Bjornis-Kaso/Smart-Energy-Meter/media/hardware/resistors_on_perfboard.jpg

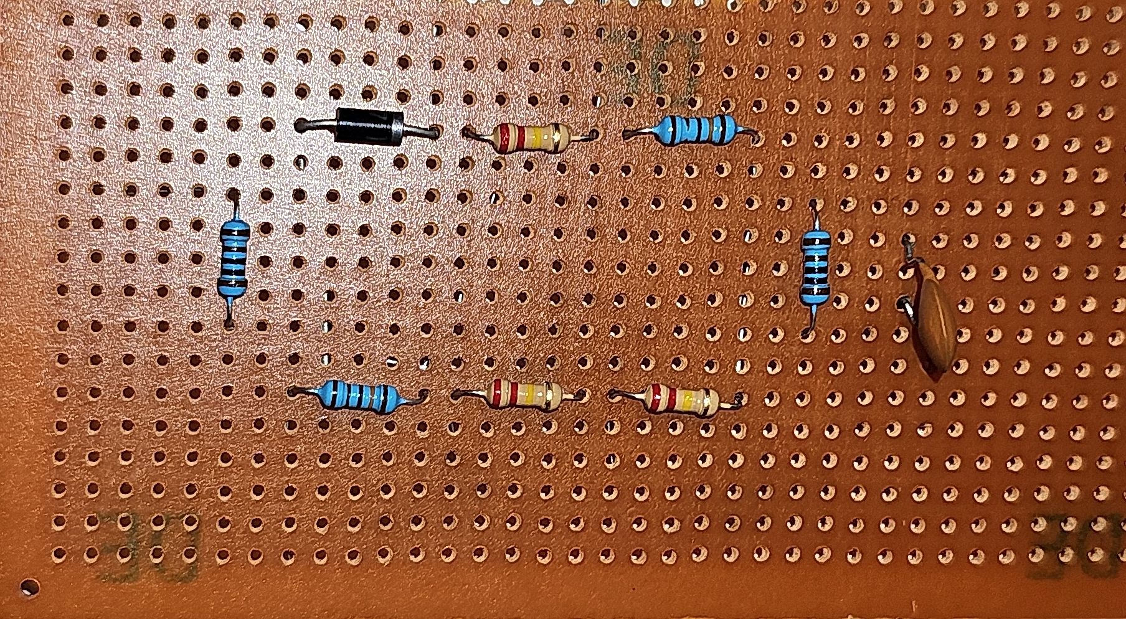
media/hardware/resistors_on_perfboard.jpg
