Bjornis-Kaso/Smart-Energy-Meter/media/schematics/V1_simulation_bjornis_klasa47.png

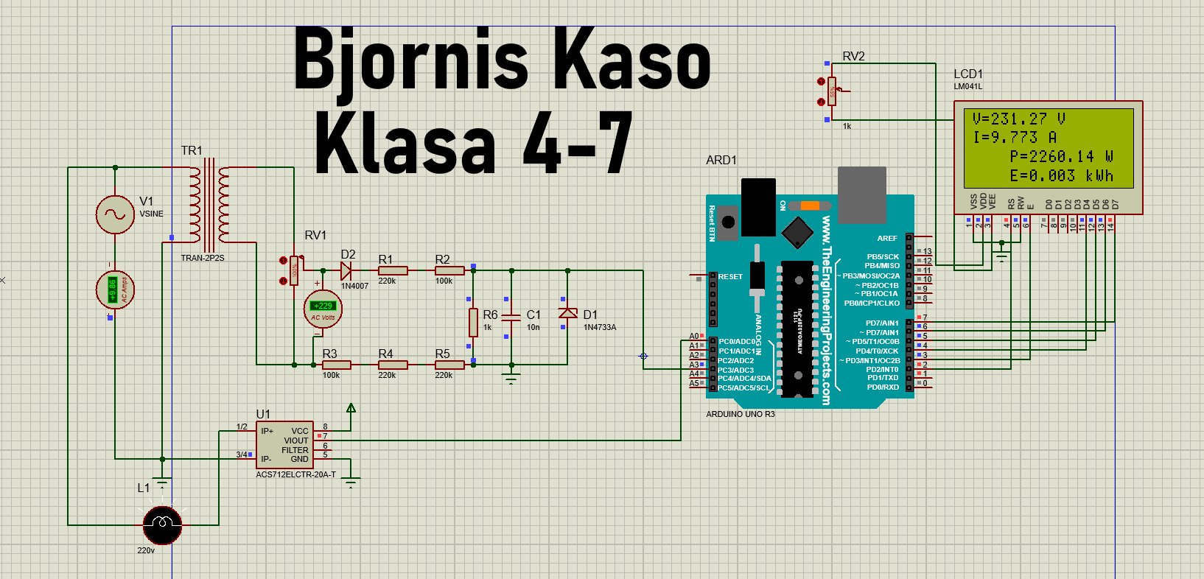
media/schematics/V1_simulation_bjornis_klasa47.png
