Bjornis-Kaso/Smart-Energy-Meter/media/schematics/V1_simulation_highload.png

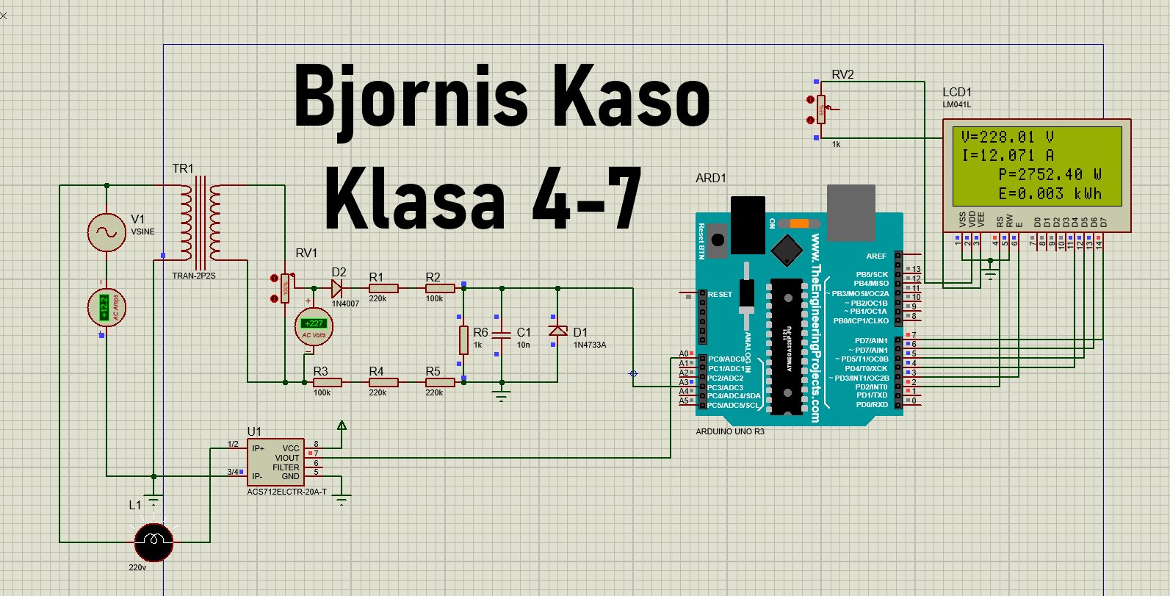
media/schematics/V1_simulation_highload.png
