Bjornis-Kaso/Smart-Energy-Meter/media/schematics/V2_simulation_running.png

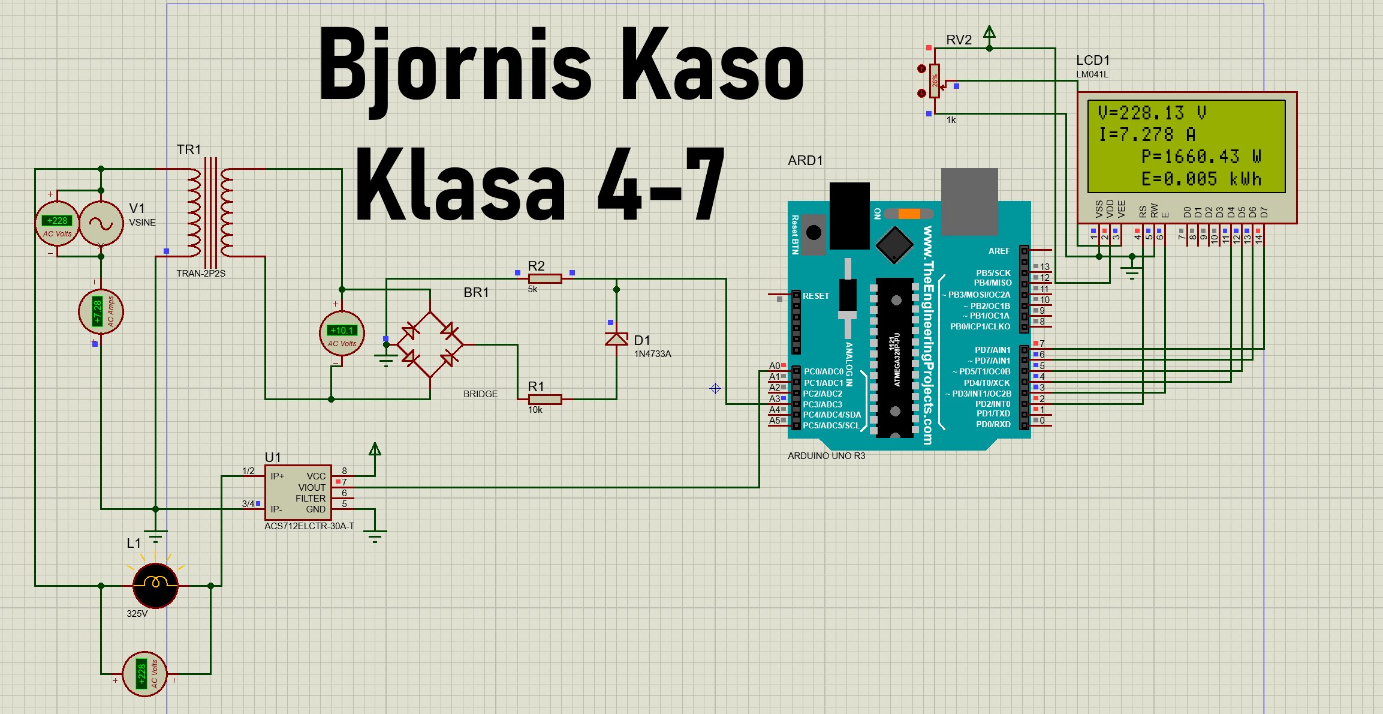
media/schematics/V2_simulation_running.png
