Bjornis-Kaso/Smart-Energy-Meter/calibration/calibration_sheet.md

# Calibration Sheet — Fletë Kalibrimi V4

**Method:** Comparison calibration  
**Date:** 21.03.2025
**Lead:** Bjornis Kaso  
**School:** Instituti Harry Fultz  

---

## Instrument Under Test (Mx) vs Reference Instrument (Mo)

**Quantity tested:** Power (W)  
**Measurement range:** Voltage 200–240 V, Current ~0.5 A  

---

## Voltage & Current Measurements

| # | Mx(V) | Mo(V) | Mx(A) | Mo(A) | Ga(V) | θ(V)  | Ga(A)  | θ(A) | Grl(V%) | Grl(A%) |
|---|---|---|---|---|---|---|---|---|---|---|
| 1 | 224.99 | 224.33 | 0.51 | 0.522 | 0.66 | -0.66 | -0.012 | 0.012 | 0.294% | 1.2%  |
| 2 | 225.70 | 225.60 | 0.51 | 0.514 | 0.10 | -0.10 | -0.004 | 0.004 | 0.044% | 0.8%  |
| 3 | 225.72 | 226.37 | 0.52 | 0.521 | -0.65| 0.65  | -0.001 | 0.001 | 0.287% | 0.2%  |
| 4 | 226.43 | 226.35 | 0.52 | 0.521 | 0.08 | -0.08 | -0.001 | 0.001 | 0.035% | 0.2%  |
| 5 | 226.84 | 227.05 | 0.51 | 0.527 | -0.21| 0.21  | -0.017 | 0.017 | 0.092% | 1.7%  |
| 6 | 227.35 | 227.05 | 0.52 | 0.527 | 0.30 | -0.30 | -0.007 | 0.007 | 0.132% | 0.7%  |
| 7 | 230.53 | 230.47 | 0.53 | 0.520 | 0.06 | -0.06 |  0.010 |-0.010 | 0.026% | -1.0% |
| 8 | 230.90 | 230.81 | 0.50 | 0.508 | 0.09 | -0.09 | -0.008 | 0.008 | 0.039% | 0.8%  |
| 9 | 231.03 | 232.05 | 0.51 | 0.515 | -1.02| 1.02  | -0.005 | 0.005 | 0.440% | 0.5%  |
|10 | 232.39 | 232.40 | 0.51 | 0.505 | -0.01| 0.01  |  0.005 |-0.005 | 0.004% | -0.5% |

---

## Power Measurements

| # | Mx(P) W | Mo(P) W | Ga(P) W | θ(P) W | Grl(P%) | Grf(P%) | Grf(V%) | Grf(A%) |
|---|---|---|---|---|---|---|---|---|
| 1 | 107.14 | 105.32 | 1.82  | -1.82 | 1.73%  | 1.70%  | 0.29%  | -1.2%  |
| 2 | 106.13 | 104.37 | 1.76  | -1.76 | 1.68%  | 1.66%  | 0.04%  | -0.4%  |
| 3 | 106.55 | 106.04 | 0.51  | -0.51 | 0.48%  | 0.48%  | 0.29%  |  0.1%  |
| 4 | 107.67 | 106.17 | 1.50  | -1.50 | 1.39%  | 1.39%  | 0.04%  |  0.1%  |
| 5 | 107.19 | 107.61 | -0.42 |  0.42 | -0.39% | 0.39%  | 0.09%  | -1.7%  |
| 6 | 108.57 | 107.61 | 0.96  | -0.96 | 0.88%  | 0.88%  | 0.13%  | -0.7%  |
| 7 | 109.12 | 107.76 | 1.36  | -1.36 | 1.25%  | 1.25%  | 0.03%  |  1.0%  |
| 8 | 106.30 | 105.57 | 0.73  | -0.73 | 0.69%  | 0.69%  | 0.04%  | -0.8%  |
| 9 | 108.49 | 107.63 | 0.86  | -0.86 | 0.79%  | 0.79%  | 0.44%  | -0.5%  |
|10 | 106.52 | 105.60 | 0.92  | -0.92 | 0.86%  | 0.86%  | 0.004% |  0.5%  |

---

## Legend

| Symbol | Meaning |
|---|---|
| Mx(V/A/P) | Reading from the instrument under test |
| Mo(V/A/P) | Reading from the reference (standard) instrument |
| Ga | Absolute error = Mx − Mo |
| θ | Correction = −Ga |
| Grl (%) | Relative error % = (Ga / Mo) × 100 |
| Grf (%) | Referenced error % = (Ga / Full-scale) × 100 |

---

## Instrument Specifications

| Parameter | Value |
|---|---|
| Quantities measured | Voltage (V), Current (A), Active Power (W), Energy (kWh) |
| Voltage range | 200 V – 240 V |
| Current range | 0 A – 30 A |
| Power range | 0 W – 7200 W |
| Max power error | ≤ 1.7% |
| Accuracy class | Class 1–2 per IEC 62053-21 |
| Operating temperature | –10 °C to +50 °C |
| Relative humidity | < 85% (non-condensing) |
| IP rating | IPX4 |

---

## Applicable Standards

- **IEC 62053-21** — Static active energy meters
- **IEC 61010-1** — Safety for measuring equipment
- **IEC 60529** — IP classification
- **Albanian Law 124/2015** — Energy efficiency
