Bjornis-Kaso/Smart-Energy-Meter/media/hardware/hairdryer_test_load_2000W.jpg

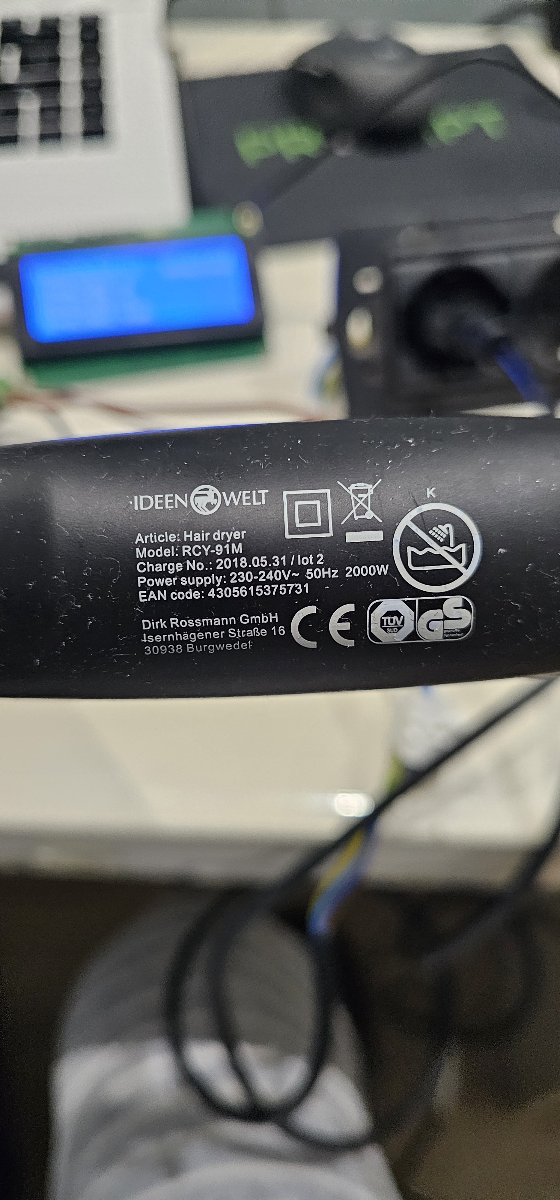
media/hardware/hairdryer_test_load_2000W.jpg
